StavJi/Nixie_Clock_Big/README.md

# NixieClockBig
Nixie clock with ZM1080 tubes

<p float="left">
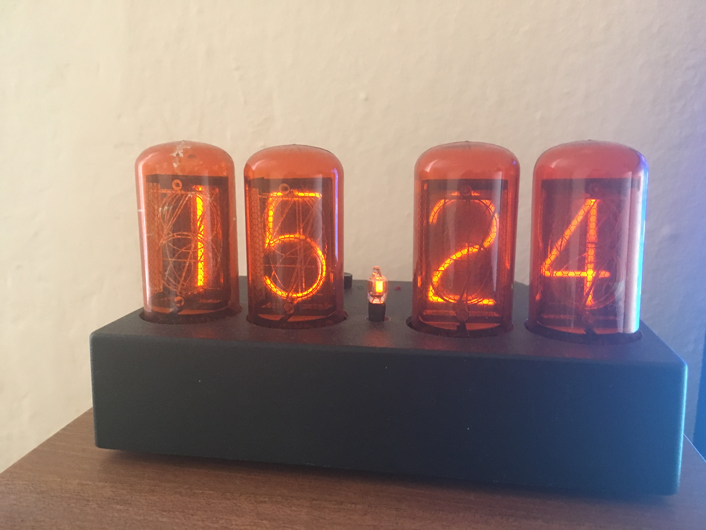
[picture p1: Photo/IMG_0652.JPG]
  
</p>
