StavJi/Nixie_Clock_Big/HW/RTC.brd

## EAGLE design HW/RTC.brd (2021-03-16)

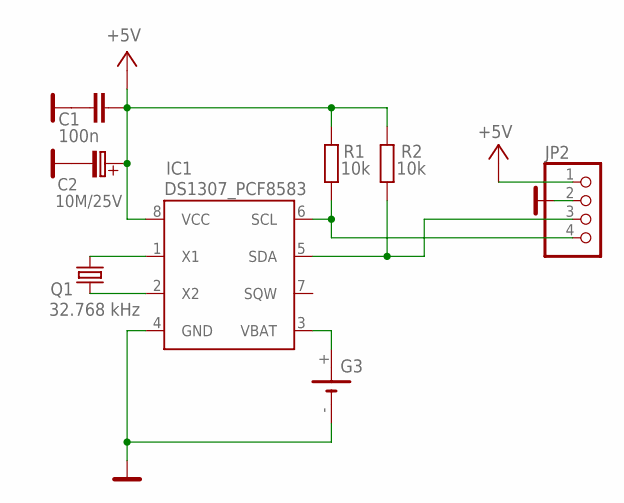
[picture p2: schematic RTC.sch]

Parts:
C1: 100n; KERAMICKY_RM5
C2: 10M/25V; C_EL_2
G3: VL1220
IC1: DS1307_PCF8583; DS1307_PCF8583_DIL08
JP2: PINHD-1X4; 1X04
Q1: 32.768 kHz; GWX-26
R1, R2: 10k; 0207/10

Connections:
+5V: C1.P$1 (1), C2.C+ (C_EL+), IC1.8 (VCC), JP2.1, R1.2, R2.2
GND: C1.P$2 (2), C2.C- (C_EL-), G3.-, IC1.4 (GND), JP2.2
unnamed: IC1.6 (SCL), JP2.4, R1.1
unnamed: IC1.5 (SDA), JP2.3, R2.1
unnamed: IC1.1 (X1), Q1.P$2 (2)
unnamed: IC1.2 (X2), Q1.P$1 (1)
unnamed: G3.+, IC1.3 (VBAT)

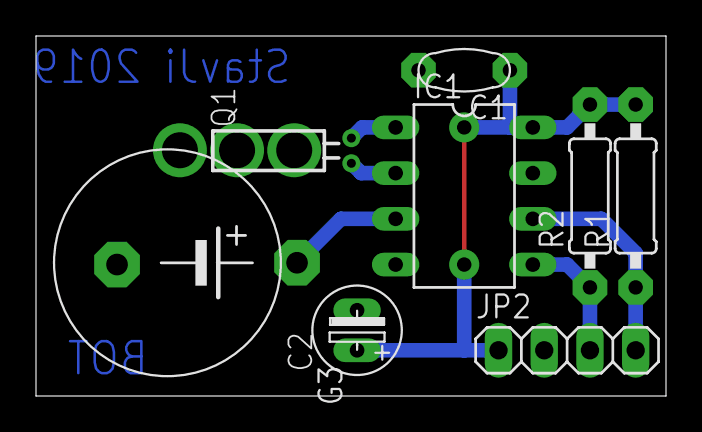
[picture p3: board RTC.brd from above]

Board: 2 copper layers, 35.0 x 20.0 mm, 8 parts (0 on the bottom side), 7 nets.
