StavJi/Nixie_Clock_Big/HW/Clock.brd

## EAGLE design HW/Clock.brd (2021-03-16)

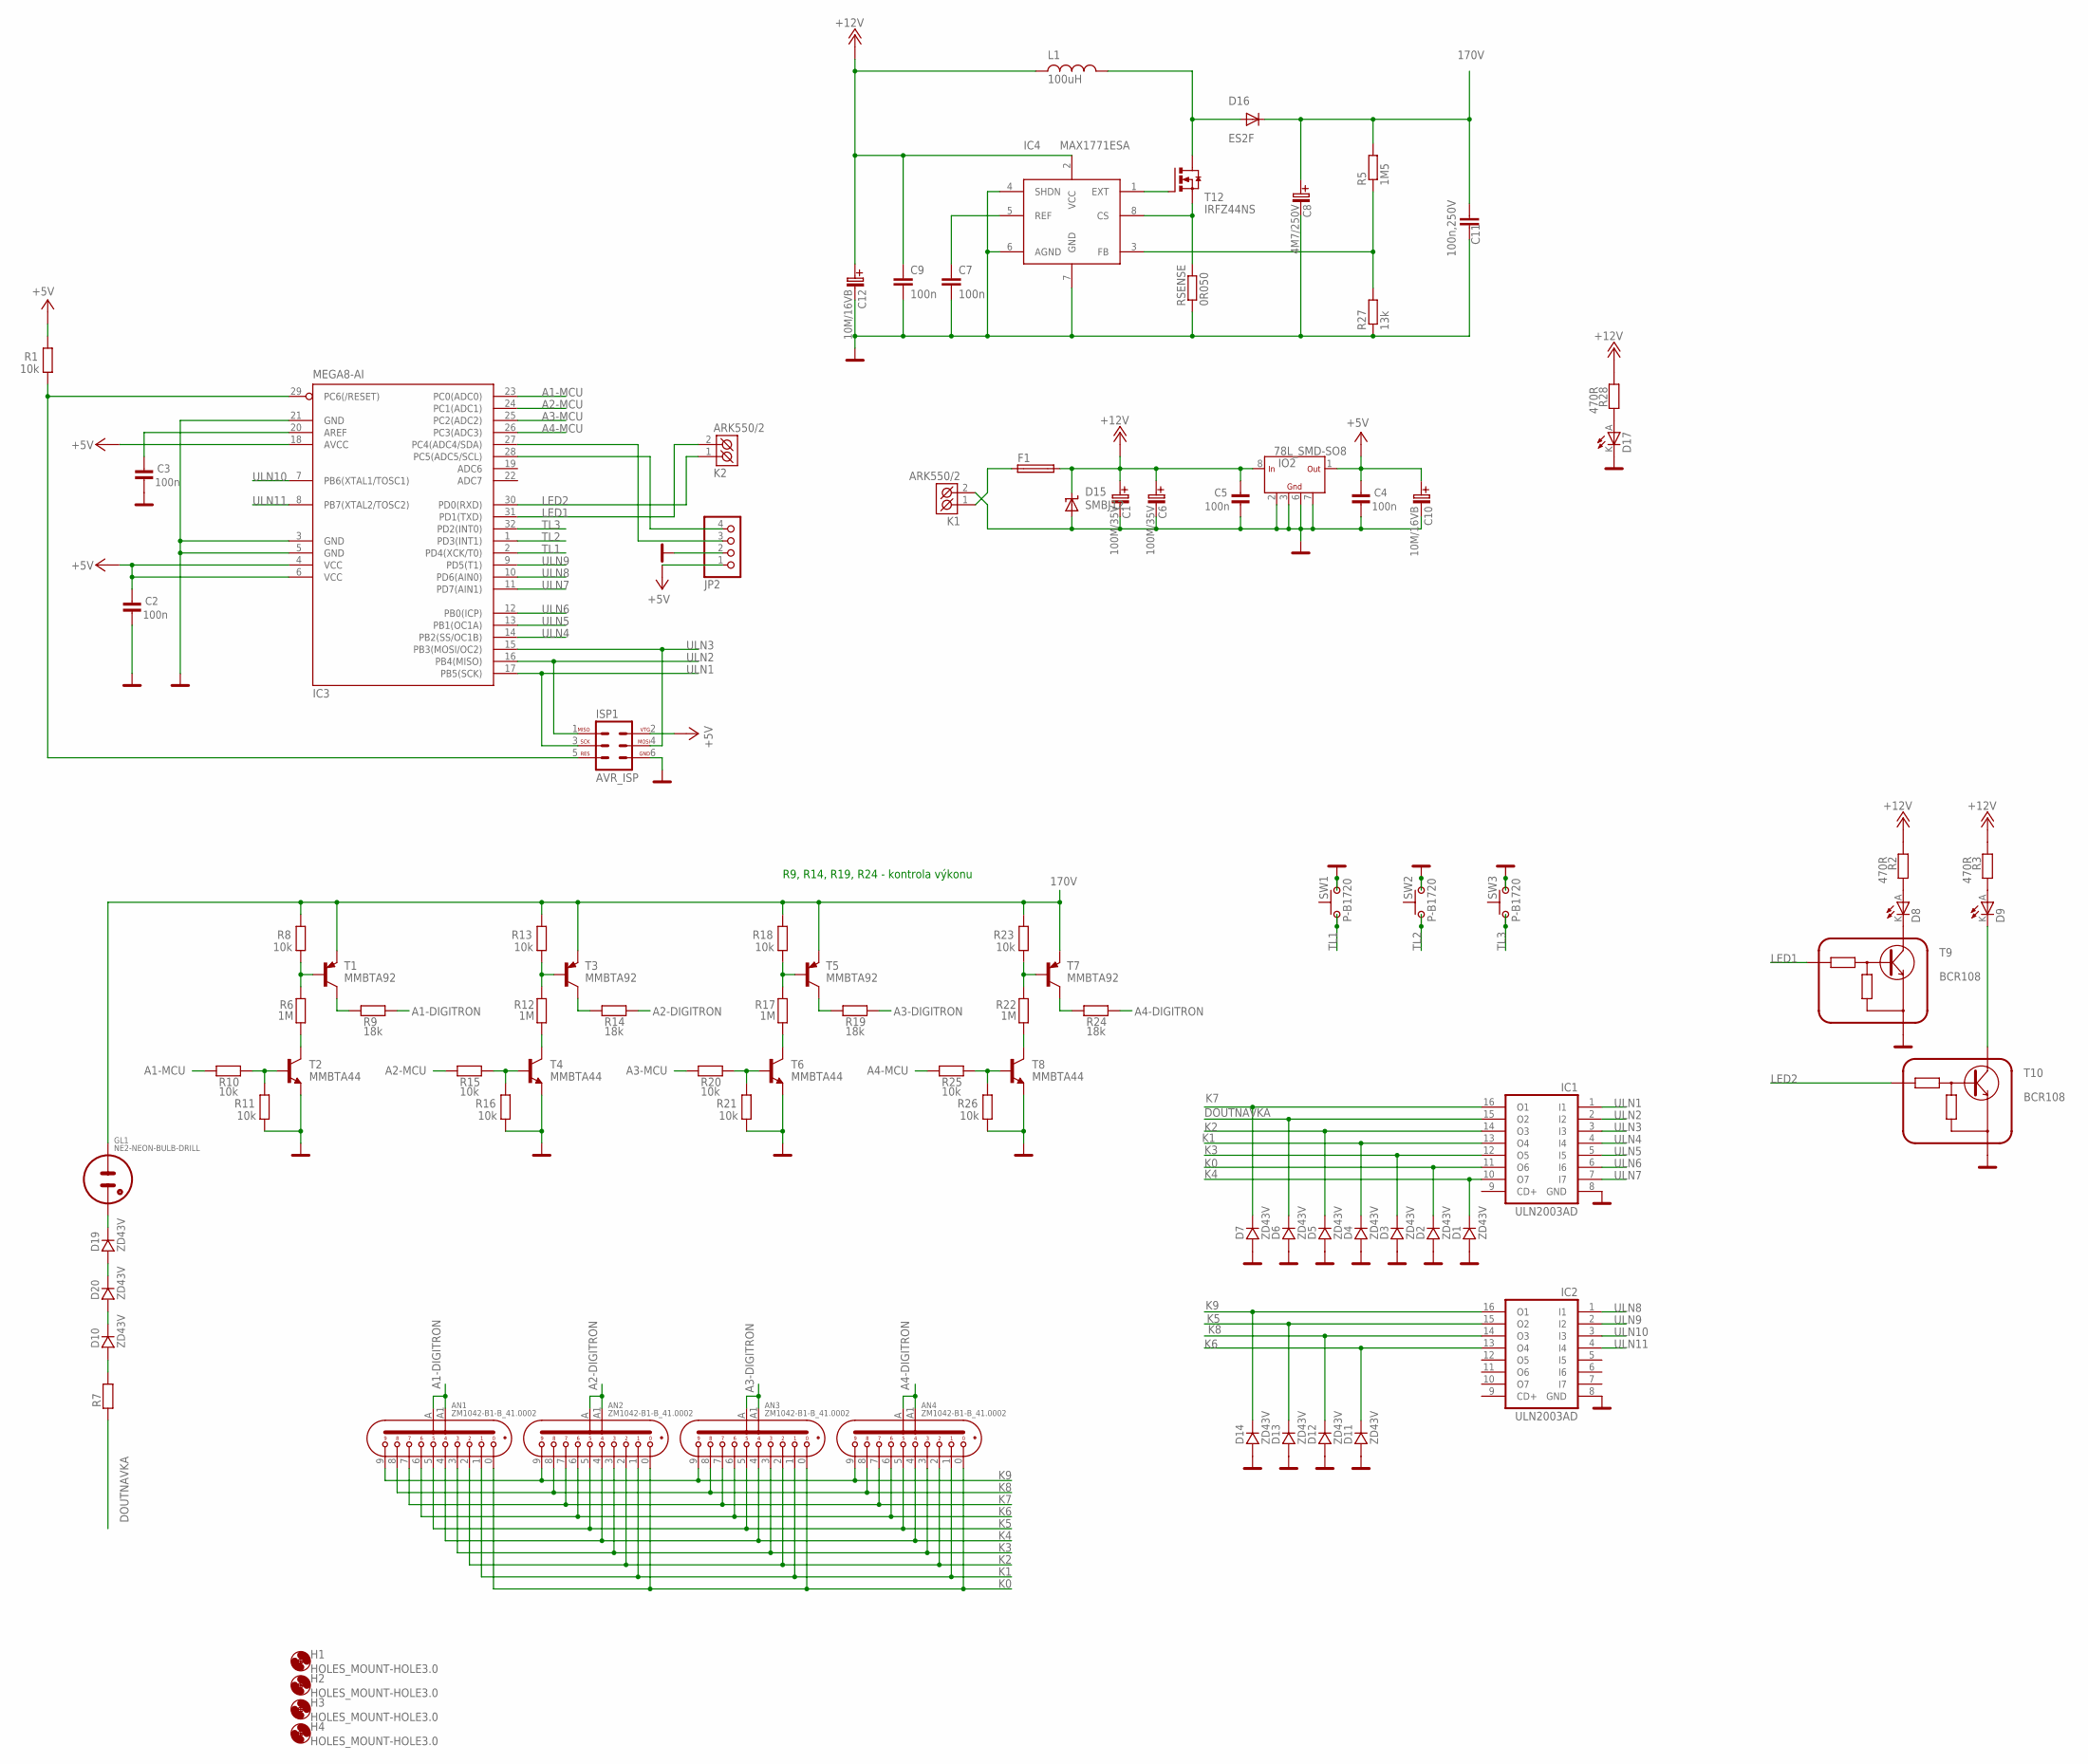
[picture p4: schematic Clock.sch]

Parts:
AN1, AN2, AN3, AN4: ZM1042-B1-B_41.0002; ZM1042-MULTI-CONTACT
C1, C6: 100M/35V; C_EL_3,5
C2, C3, C4, C5: 100n; 0805
C7, C9: 100n; C0805
C8: 4M7/250V; C_EL_3,5
C10, C12: 10M/16VB; B
C11: 100n,250V; C2420
D1, D2, D3, D4, D5, D6, D7, D10, D11, D12, D13, D14, D19, D20: ZD43V; SOD-80
D8, D9, D17: LEDLED3MM; LED3MM
D15: SMBJ12; SMBJ
D16: ES2F; SMC
F1: TE5
GL1: NE2-NEON-BULB-DRILL
H1, H2, H3, H4: HOLES_MOUNT-HOLE3.0; HOLES_3,0
IC1, IC2: ULN2003AD; SO16
IC3: MEGA8-AI; TQFP32-08
IC4: MAX1771ESA; SO-8
IO2: 78L_SMD-SO8; SO08
ISP1: AVR_ISP; MLW06G
JP2: PINHD-1X4; 1X04
K1, K2: ARK550/2
L1: 100uH; L-B82479
R1, R8, R10, R11, R13, R15, R16, R18, R20, R21, R23, R25, R26: 10k; 0805
R2, R3, R28: 470R; 0805
R5: 1M5; R0805
R6, R12, R17, R22: 1M; 0805
R7: W2_180K; R__2W
R9, R14, R19, R24: 18k; 1206
R27: 13k; R0805
RSENSE: 0R050; R2010
SW1, SW2, SW3: P-B1720
T1, T3, T5, T7: MMBTA92; SOT23-BEC
T2, T4, T6, T8: MMBTA44; SOT23-BEC
T9, T10: BCR108; SOT-23
T12: IRFZ44NS; D2PACK

Connections:
170V: C8.C+ (C_EL+), C11.P$1 (1), D16.C, GL1.1 (A), R5.2, R8.2, R13.2, R18.2, R23.2, T1.E, T3.E, T5.E, T7.E
+5V: C2.2, C4.2, C10.+ (C_EL+), IC3.4 (VCC), IC3.6 (VCC), IC3.18 (AVCC), IO2.1 (OUT), ISP1.2, JP2.1, R1.2
A1-DIGITRON: AN1.A (A1), AN1.A1 (A2), R9.1
A1-MCU: IC3.23 (PC0(ADC0)), R10.2
A2-DIGITRON: AN2.A (A1), AN2.A1 (A2), R14.1
A2-MCU: IC3.24 (PC1(ADC1)), R15.2
A3-DIGITRON: AN3.A (A1), AN3.A1 (A2), R19.1
A3-MCU: IC3.25 (PC2(ADC2)), R20.2
A4-DIGITRON: AN4.A (A1), AN4.A1 (A2), R24.1
A4-MCU: IC3.26 (PC3(ADC3)), R25.2
DCF: IC3.27 (PC4(ADC4/SDA)), JP2.3
DOUTNAVKA: D6.K, IC1.15 (O2), R7.1
EXT: IC4.1 (EXT), T12.1 (G)
GND: C1.C- (C_EL-), C2.1, C3.1, C4.1, C5.1, C6.C- (C_EL-), C7.2, C8.C- (C_EL-), C9.2, C10.- (C_EL-), C11.P$2 (2), C12.- (C_EL-), D1.A, D2.A, D3.A, D4.A, D5.A, D6.A, D7.A, D11.A, D12.A, D13.A, D14.A, D15.A, D17.K (C), IC1.8 (GND), IC2.8 (GND), IC3.3 (GND), IC3.5 (GND), IC3.21 (GND), IC4.4 (SHDN), IC4.6 (AGND), IC4.7 (GND), IO2.2 (GND), IO2.3 (GND), IO2.6 (GND), IO2.7 (GND), ISP1.6, JP2.2, K1.2 (K2), R11.1, R16.1, R21.1, R26.1, R27.1, RSENSE.1, SW1.2, SW1.4, SW2.2, SW2.4, SW3.2, SW3.4, T2.E, T4.E, T6.E, T8.E, T9.2 (E), T10.2 (E)
K0: AN1.0, AN2.0, AN3.0, AN4.0, D2.K, IC1.11 (O6)
K1: AN1.1, AN2.1, AN3.1, AN4.1, D4.K, IC1.13 (O4)
K2: AN1.2, AN2.2, AN3.2, AN4.2, D5.K, IC1.14 (O3)
K3: AN1.3, AN2.3, AN3.3, AN4.3, D3.K, IC1.12 (O5)
K4: AN1.4, AN2.4, AN3.4, AN4.4, D1.K, IC1.10 (O7)
K5: AN1.5, AN2.5, AN3.5, AN4.5, D13.K, IC2.15 (O2)
K6: AN1.6, AN2.6, AN3.6, AN4.6, D11.K, IC2.13 (O4)
K7: AN1.7, AN2.7, AN3.7, AN4.7, D7.K, IC1.16 (O1)
K8: AN1.8, AN2.8, AN3.8, AN4.8, D12.K, IC2.14 (O3)
K9: AN1.9, AN2.9, AN3.9, AN4.9, D14.K, IC2.16 (O1)
LED1: IC3.31 (PD1(TXD)), K2.2 (K2), T9.1 (B)
LED2: IC3.30 (PD0(RXD)), K2.1 (K1), T10.1 (B)
LED3: IC3.28 (PC5(ADC5/SCL)), JP2.4
unnamed: C3.2, IC3.20 (AREF)
unnamed: C1.C+ (C_EL+), C5.2, C6.C+ (C_EL+), C9.1, C12.+ (C_EL+), D15.C, F1.2, IC4.2 (VCC), IO2.8 (IN), L1.P$1 (1), R2.2, R3.2, R28.2
unnamed: F1.1, K1.1 (K1)
unnamed: D8.K (C), T9.3 (C)
unnamed: D9.K (C), T10.3 (C)
unnamed: D10.A, R7.2
unnamed: D8.A, R2.1
unnamed: D9.A, R3.1
unnamed: D10.K, D20.A
unnamed: D19.K, GL1.2 (A1)
unnamed: IC4.3 (FB), R5.1, R27.2
unnamed: C7.1, IC4.5 (REF)
unnamed: D16.A, L1.P$2 (2), T12.2 (D)
unnamed: IC4.8 (CS), RSENSE.2, T12.3 (S)
unnamed: IC3.29 (PC6(/RESET)), ISP1.5, R1.1
unnamed: D19.A, D20.K
unnamed: D17.A, R28.1
unnamed: R6.2, R8.1, T1.B
unnamed: R9.2, T1.C
unnamed: R6.1, T2.C
unnamed: R10.1, R11.2, T2.B
unnamed: R12.2, R13.1, T3.B
unnamed: R14.2, T3.C
unnamed: R12.1, T4.C
unnamed: R15.1, R16.2, T4.B
unnamed: R17.2, R18.1, T5.B
unnamed: R19.2, T5.C
unnamed: R17.1, T6.C
unnamed: R20.1, R21.2, T6.B
unnamed: R22.2, R23.1, T7.B
unnamed: R24.2, T7.C
unnamed: R22.1, T8.C
unnamed: R25.1, R26.2, T8.B
TL1: IC3.2 (PD4(XCK/T0)), SW1.1, SW1.3
TL2: IC3.1 (PD3(INT1)), SW2.1, SW2.3
TL3: IC3.32 (PD2(INT0)), SW3.1, SW3.3
ULN1: IC1.1 (I1), IC3.17 (PB5(SCK)), ISP1.3
ULN2: IC1.2 (I2), IC3.16 (PB4(MISO)), ISP1.1
ULN3: IC1.3 (I3), IC3.15 (PB3(MOSI/OC2)), ISP1.4
ULN4: IC1.4 (I4), IC3.14 (PB2(SS/OC1B))
ULN5: IC1.5 (I5), IC3.13 (PB1(OC1A))
ULN6: IC1.6 (I6), IC3.12 (PB0(ICP))
ULN7: IC1.7 (I7), IC3.11 (PD7(AIN1))
ULN8: IC2.1 (I1), IC3.10 (PD6(AIN0))
ULN9: IC2.2 (I2), IC3.9 (PD5(T1))
ULN10: IC2.3 (I3), IC3.7 (PB6(XTAL1/TOSC1))
ULN11: IC2.4 (I4), IC3.8 (PB7(XTAL2/TOSC2))

Notes on the sheet:
R9, R14, R19, R24 - kontrola výkonu

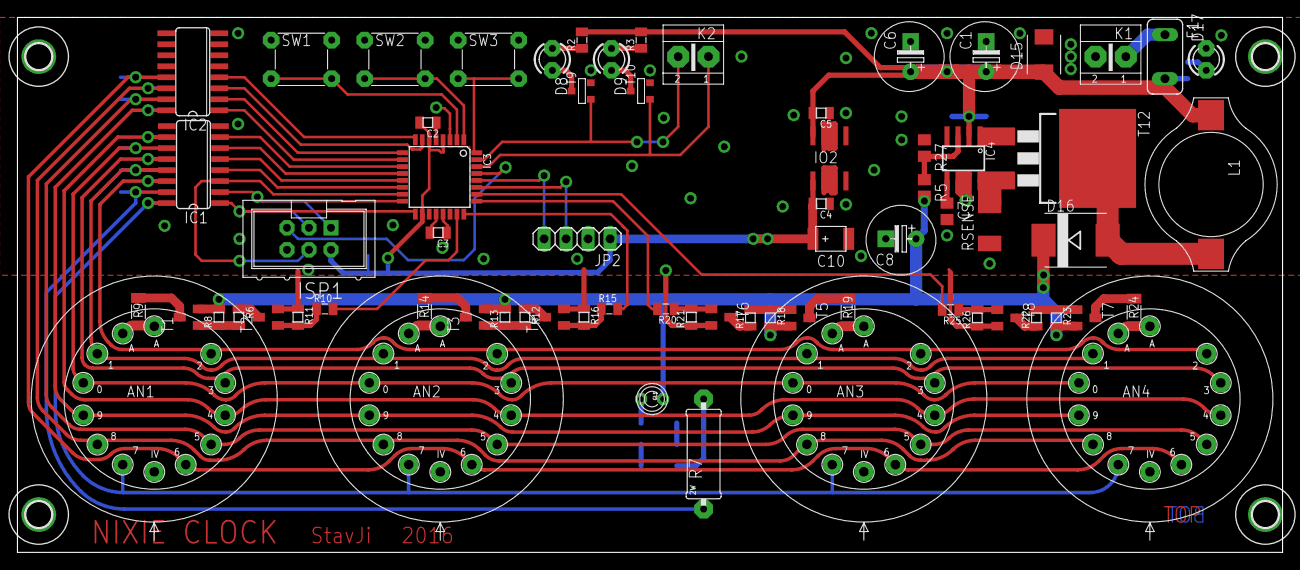
[picture p5: board Clock.brd from above]

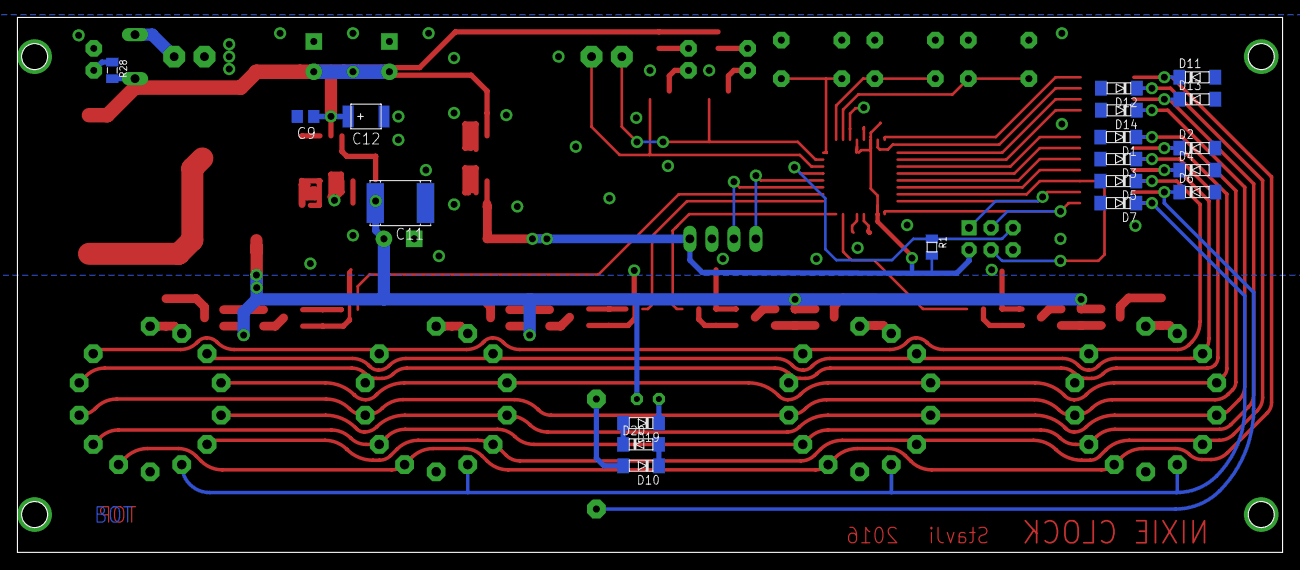
[picture p6: board Clock.brd from below]

Board: 2 copper layers, 146.1 x 61.8 mm, 93 parts (19 on the bottom side), 74 nets.
