StavJi/Nixie_Clock_Big/(notices)

Notices in the files:
parts and their libraries:
Copyright (C) Vlada 2004-2005
Copyright (C) PaJa 2001-2011
Copyright (C) PaJa 2003-2009
golledge_full_v1-0: © Golledge Electronics Ltd 2015. Released under GNU General Public License. Full library V1.0.
Copyright (C) PaJa 2001-2010
Copyright (C) PaJa 2011
Copyright (C) PaJa 2009
